SIUE-ARC/cartboard/release-v1/cartboard-F.SilkS.pdf

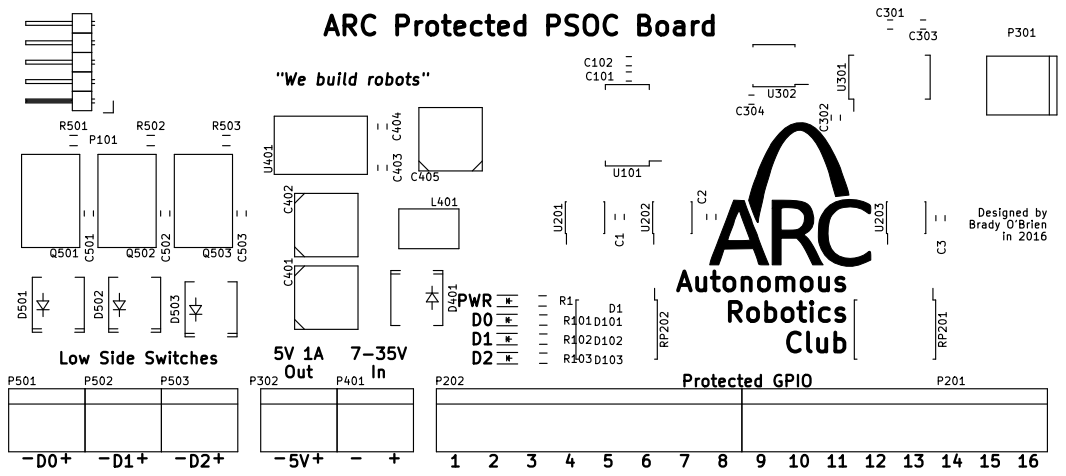
[picture p1: page 1]

in 2016 ARC Protected PSOC Board

Designed by Brady O'Brien
