SIUE-ARC/cartboard/release-v1/cartboard.pdf

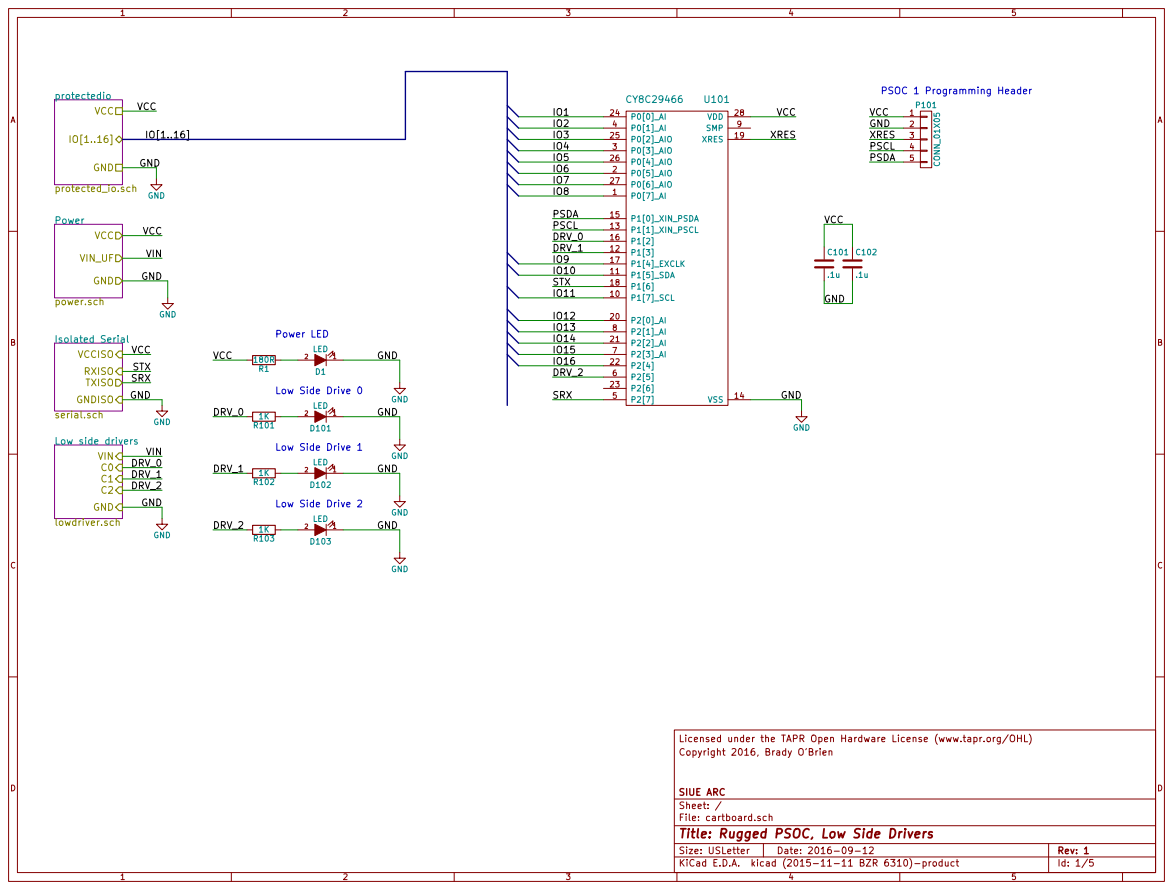
[picture p2: page 1]

Isolated Serial serial.sch VCCISO

Licensed under the TAPR Open Hardware License (www.tapr.org/OHL)
Copyright 2016, Brady O'Brien

File: cartboard.sch Sheet: / SIUE ARC

Id: 1/5 Title: Rugged PSOC, Low Side Drivers

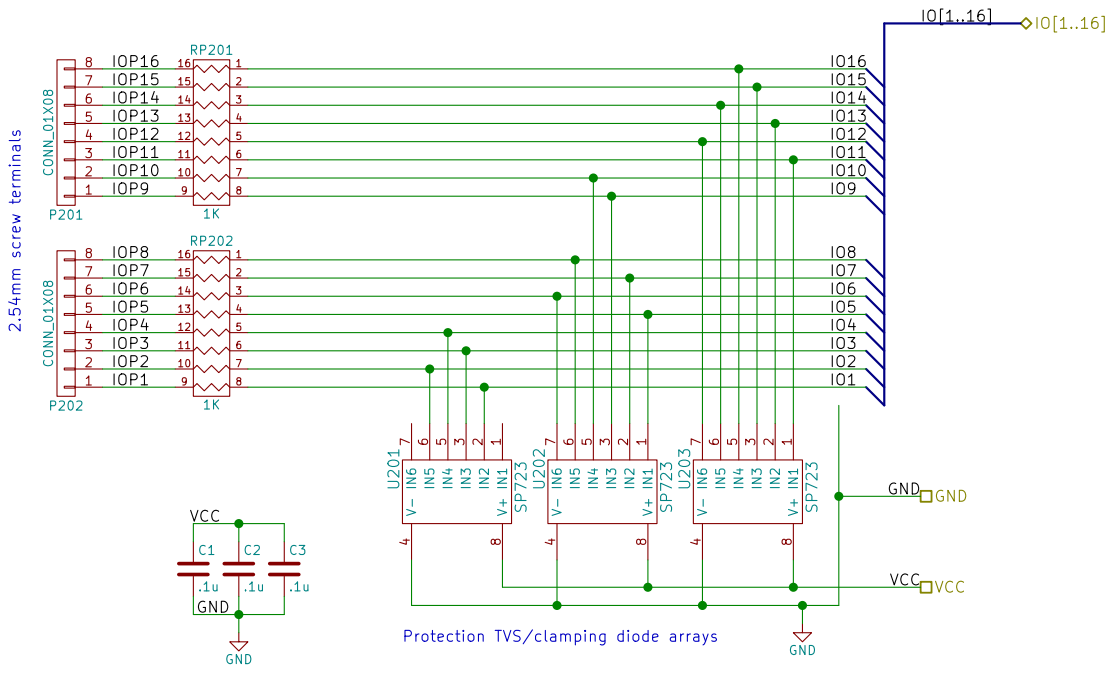
[picture p3: page 2]

2 | IO15
3 | | IO14
4 | | | IO13
5 | | | | IO12
6 | | | | | IO11
7 | | | | | | IO10

2 | IO7
3 | | IO6
4 | | | IO5
5 | | | | IO4
6 | | | | | IO3
7 | | | | | | IO2

Protection TVS/clamping diode arraysIN1

Licensed under the TAPR Open Hardware License (www.tapr.org/OHL)
Copyright 2016, Brady O'Brien

Sheet: /protectedio/ SIUE ARC

File: protected_io.sch
Id: 2/5 Title: Rugged PSOC, Low Side Drivers

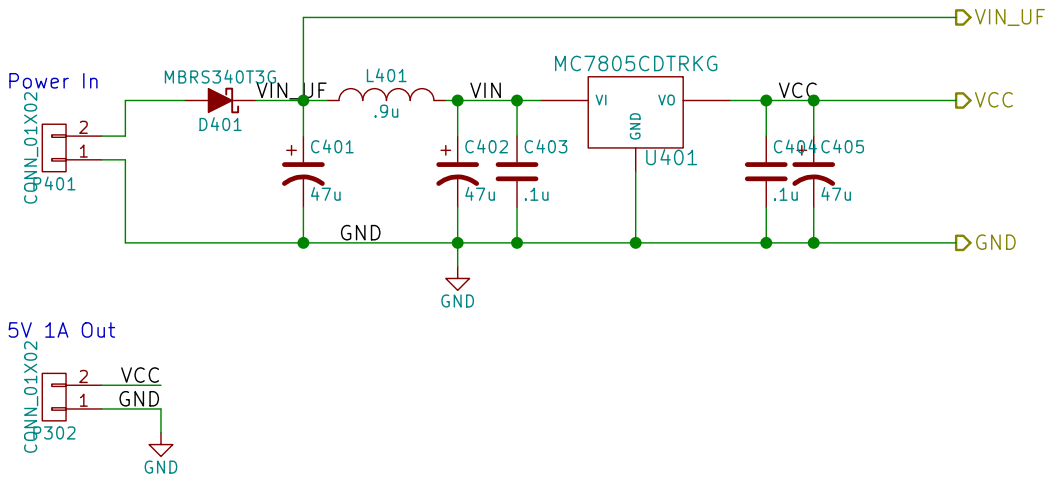
[picture p4: page 3]

Licensed under the TAPR Open Hardware License (www.tapr.org/OHL)
Copyright 2016, Brady O'Brien

File: power.sch Sheet: /Power/ SIUE ARC

Id: 3/5 Title: Rugged PSOC, Low Side Drivers

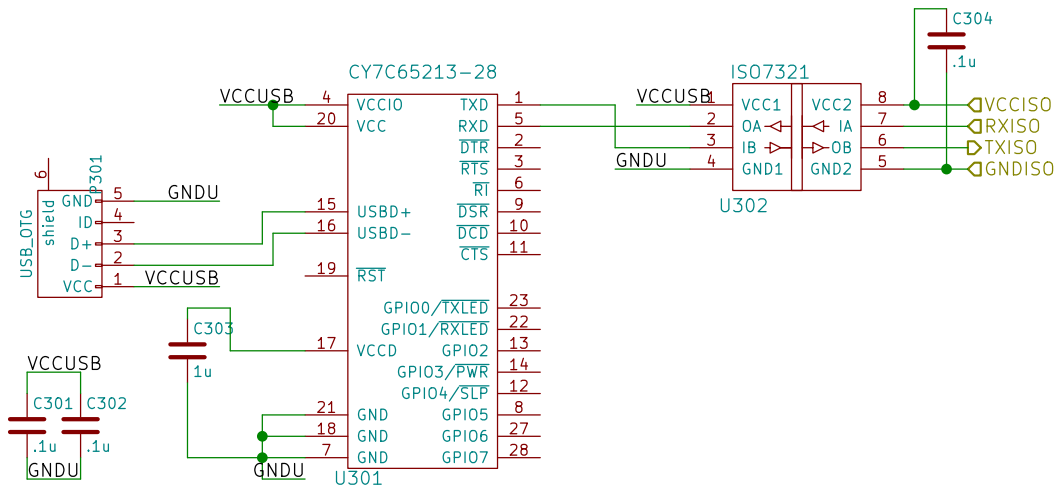
[picture p5: page 4]

Licensed under the TAPR Open Hardware License (www.tapr.org/OHL)
Copyright 2016, Brady O'Brien

File: serial.sch Sheet: /Isolated Serial/ SIUE ARC

Id: 4/5 Title: Rugged PSOC, Low Side Drivers

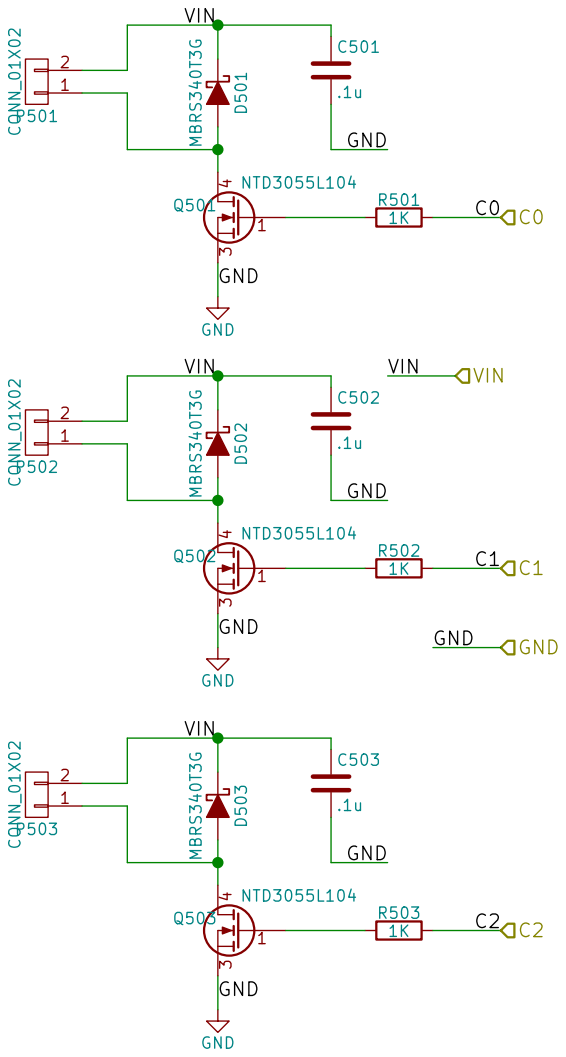
[picture p6: page 5]

Licensed under the TAPR Open Hardware License (www.tapr.org/OHL) D501 MBRS340T3G 1

File: lowdriver.sch Sheet: /Low side drivers/ SIUE ARC

Id: 5/5 Title: Rugged PSOC, Low Side Drivers
