SIUE-ARC/cartboard/release-v1/cartboard-B.Cu.pdf

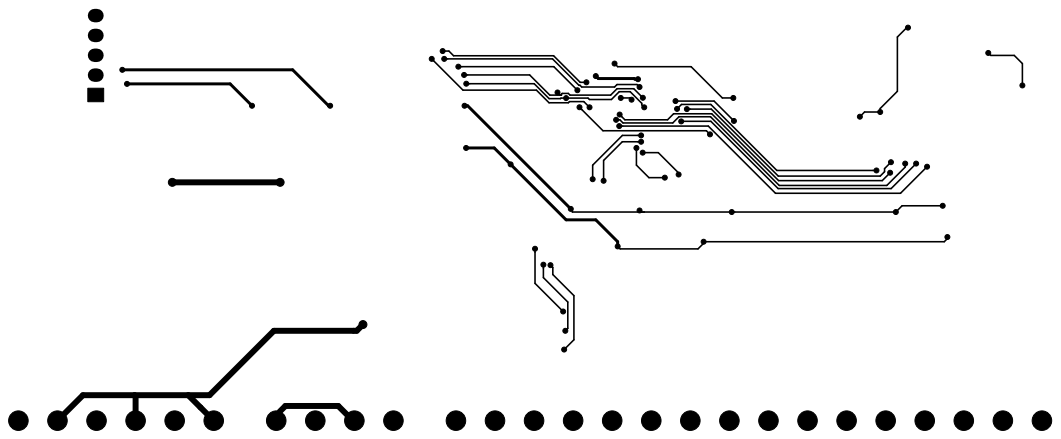
[picture p7: page 1]
