SIUE-ARC/cartboard/release-v1/cartboard-B.Mask.pdf

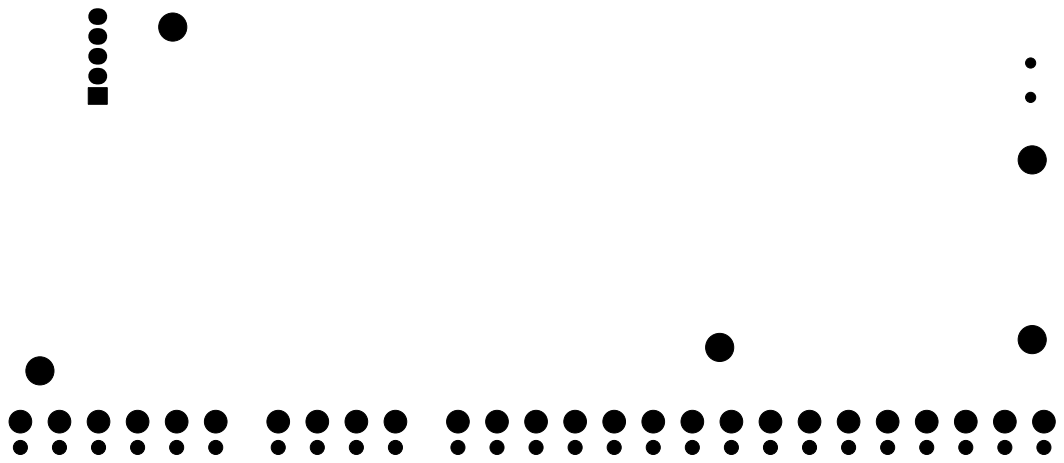
[picture p8: page 1]
