SIUE-ARC/cartboard/release-v1/cartboard-B.SilkS.pdf

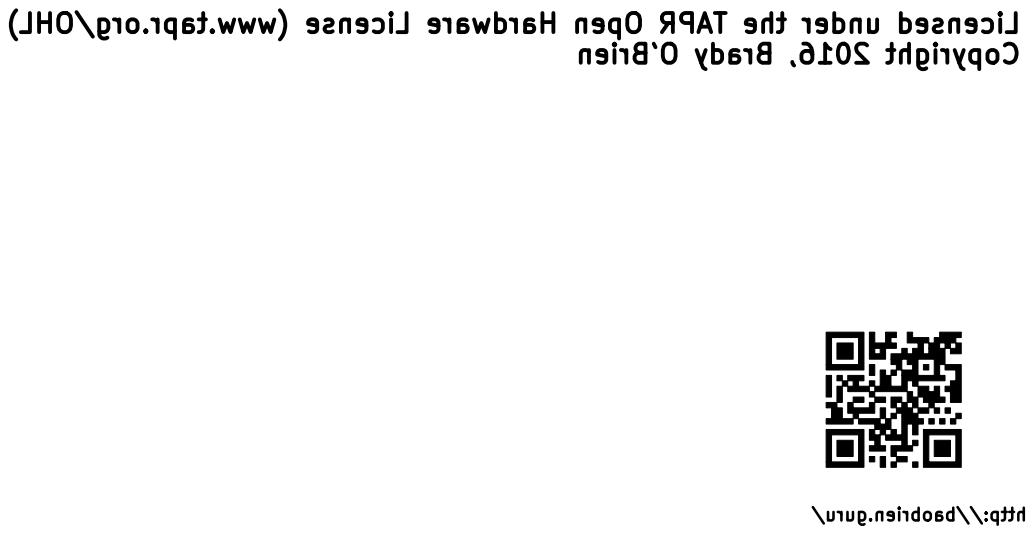
[picture p9: page 1]

Licensed under the TAPR Open Hardware License (www.tapr.org/OHL)
