SIUE-ARC/cartboard/release-v1/cartboard-Cmts.User.pdf

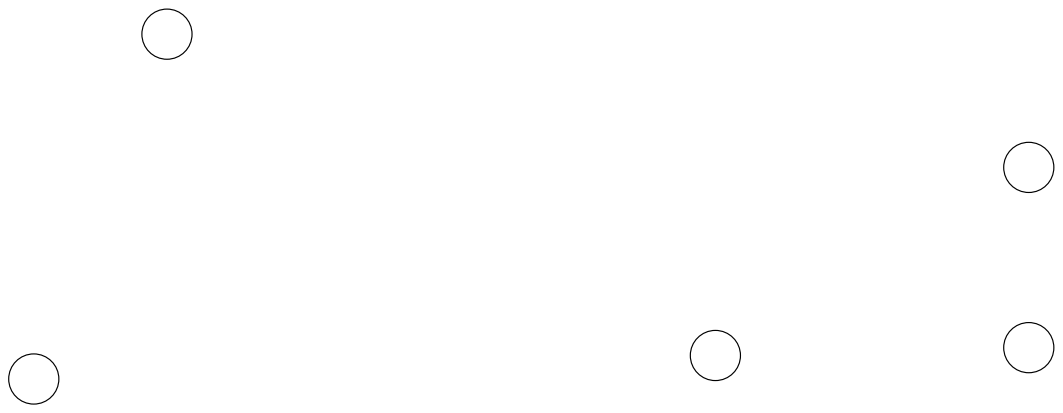
[picture p10: page 1]
