SIUE-ARC/cartboard/release-v1/cartboard-Dwgs.User.pdf

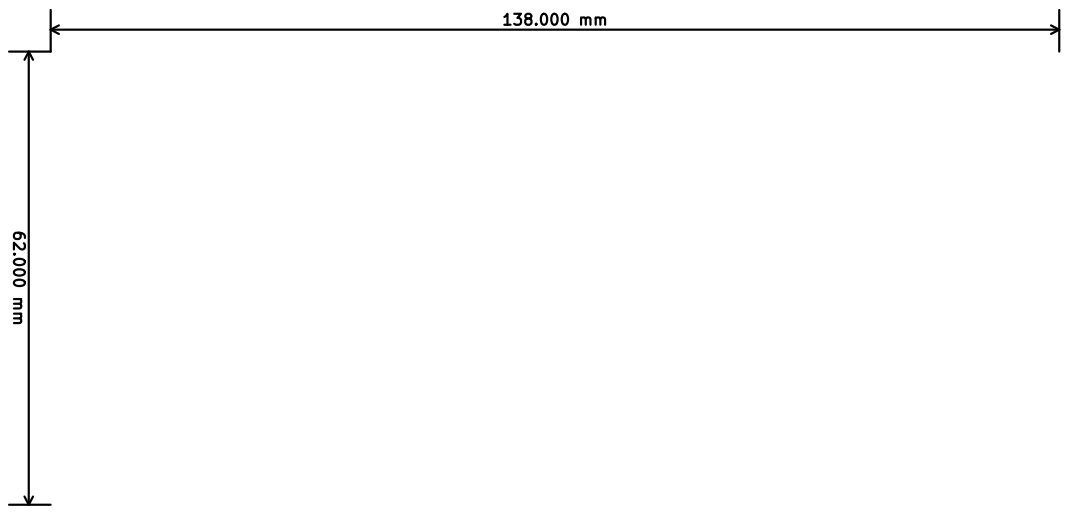
[picture p11: page 1]
