SIUE-ARC/cartboard/release-v1/cartboard-F.Cu.pdf

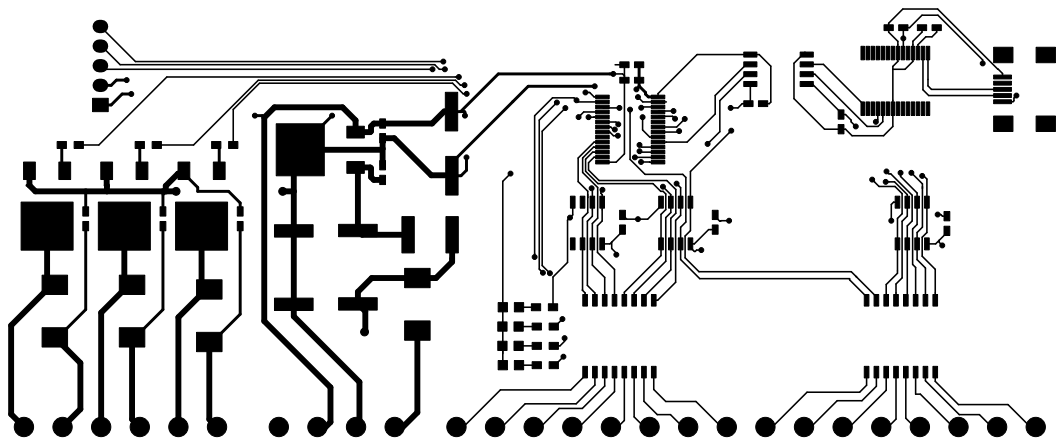
[picture p12: page 1]
