SIUE-ARC/cartboard/release-v1/cartboard-F.Mask.pdf

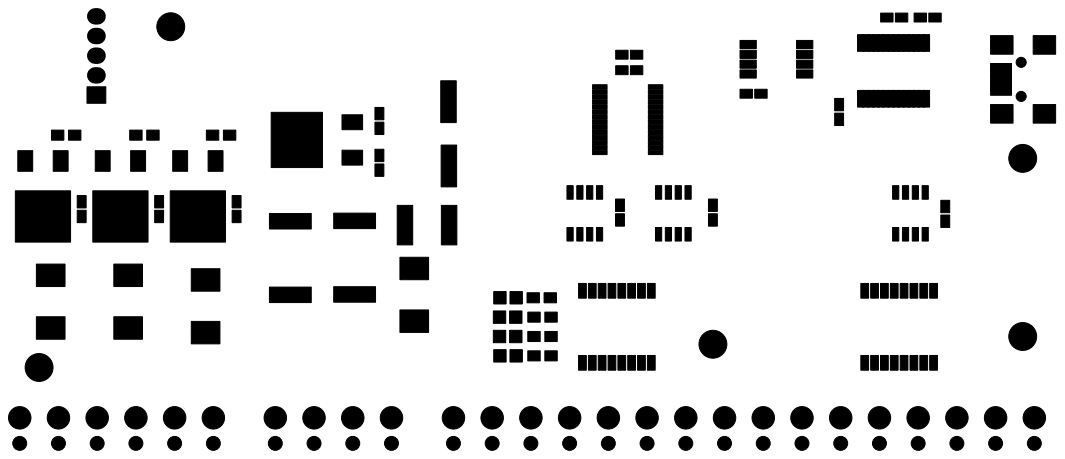
[picture p13: page 1]
