SIUE-ARC/cartboard/release-v1/cartboard-F.Paste.pdf

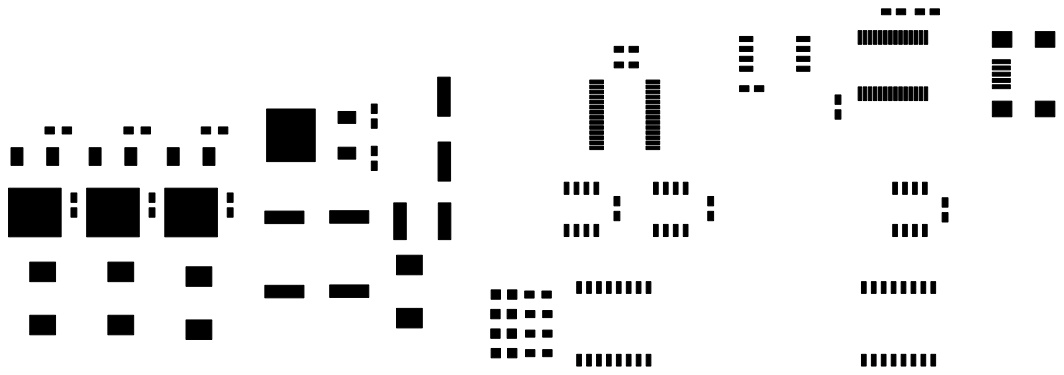
[picture p14: page 1]
