SIUE-ARC/cartboard/cartboard.kicad_pcb

## KiCad design cartboard.kicad_pcb (2016-09-12)

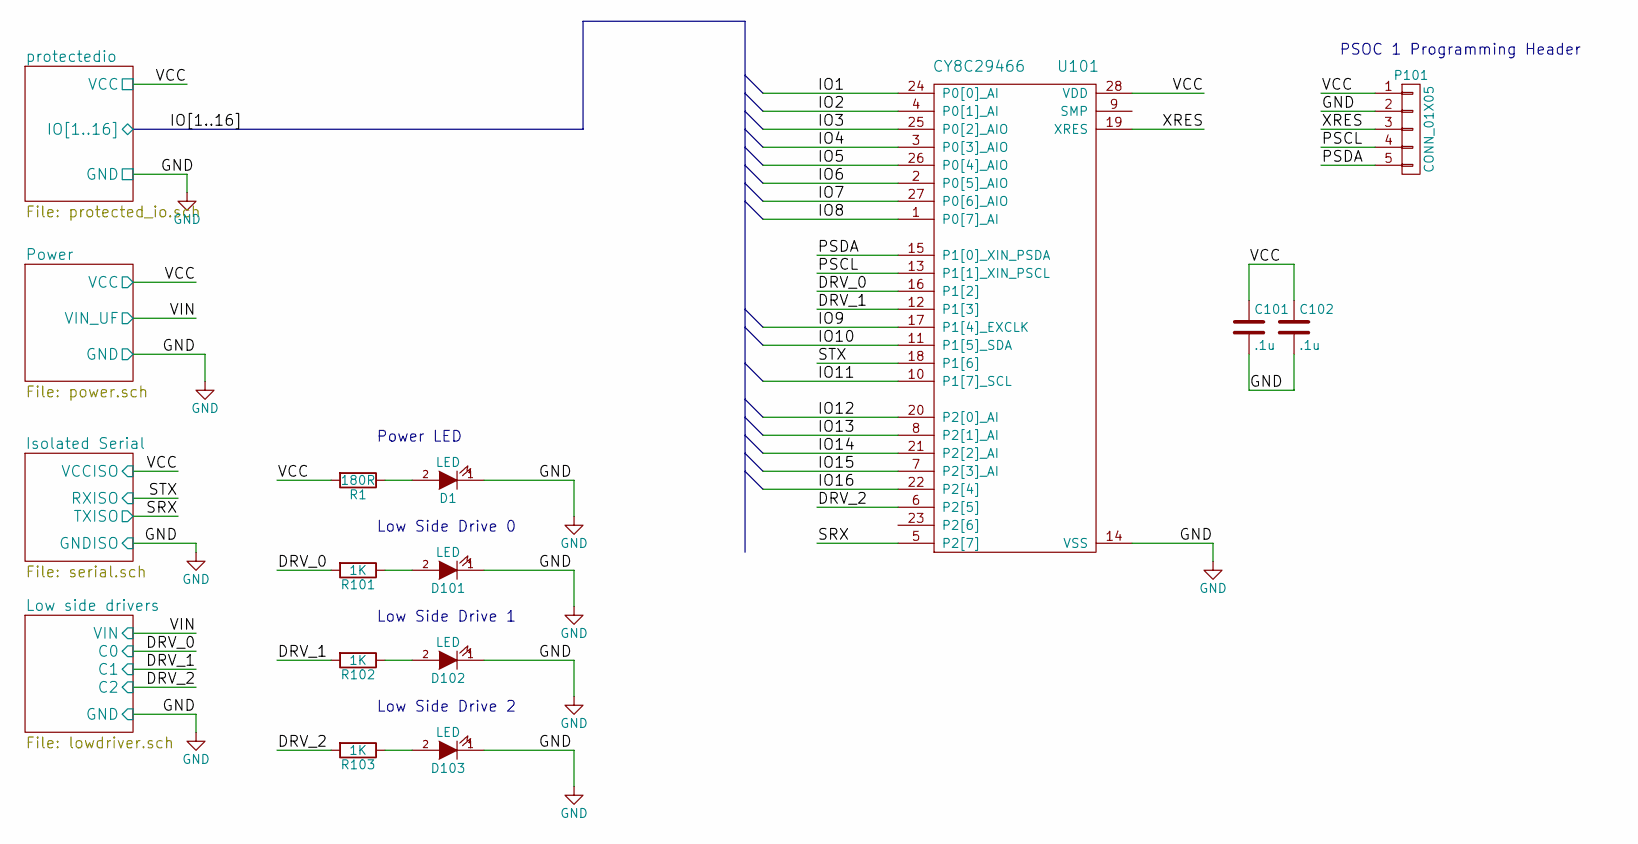
[picture p15: schematic cartboard.sch, Rugged PSOC, Low Side Drivers]

Parts:
C101, C102: .1u; C_0603_HandSoldering
D1, D101, D102, D103: LED; LED_0805; Part APT2012SGC
P101: CONN_01X05; Pin_Header_Angled_1x05; Part WM4203-ND
R1: 180R; R_0603_HandSoldering
R101, R102, R103: 1K; R_0603_HandSoldering
U101: CY8C29466; SSOP-28_5.3x10.2mm_Pitch0.65mm

Connections:
/IO1: U101.24 (P0[0]_AI); also elsewhere on the board
/IO2: U101.4 (P0[1]_AI); also elsewhere on the board
/IO3: U101.25 (P0[2]_AIO); also elsewhere on the board
/IO4: U101.3 (P0[3]_AIO); also elsewhere on the board
/IO5: U101.26 (P0[4]_AIO); also elsewhere on the board
/IO6: U101.2 (P0[5]_AIO); also elsewhere on the board
/IO7: U101.27 (P0[6]_AIO); also elsewhere on the board
/IO8: U101.1 (P0[7]_AI); also elsewhere on the board
/IO9: U101.17 (P1[4]_EXCLK); also elsewhere on the board
/IO10: U101.11 (P1[5]_SDA); also elsewhere on the board
/IO11: U101.10 (P1[7]_SCL); also elsewhere on the board
/IO12: U101.20 (P2[0]_AI); also elsewhere on the board
/IO13: U101.8 (P2[1]_AI); also elsewhere on the board
/IO14: U101.21 (P2[2]_AI); also elsewhere on the board
/IO15: U101.7 (P2[3]_AI); also elsewhere on the board
/IO16: U101.22 (P2[4]); also elsewhere on the board
/Isolated Serial/RXISO: U101.18 (P1[6]); also elsewhere on the board
/Isolated Serial/TXISO: U101.5 (P2[7]); also elsewhere on the board
/Low side drivers/C0: R101.2, U101.16 (P1[2]); also elsewhere on the board
/Low side drivers/C1: R102.2, U101.12 (P1[3]); also elsewhere on the board
/Low side drivers/C2: R103.2, U101.6 (P2[5]); also elsewhere on the board
/PSCL: P101.4, U101.13 (P1[1]_XIN_PSCL)
/PSDA: P101.5, U101.15 (P1[0]_XIN_PSDA)
/Power/VCC: C101.1, C102.1, P101.1, R1.2, U101.28 (VDD); also elsewhere on the board
/XRES: P101.3, U101.19 (XRES)
GND: C101.2, C102.2, D1.1 (K), D101.1 (K), D102.1 (K), D103.1 (K), P101.2, U101.14 (VSS); also elsewhere on the board
unnamed: D1.2 (A), R1.1
unnamed: D101.2 (A), R101.1
unnamed: D102.2 (A), R102.1
unnamed: D103.2 (A), R103.1

Notes on the sheet:
PSOC 1 Programming Header
Power LED
Low Side Drive 0
Low Side Drive 1
Low Side Drive 2

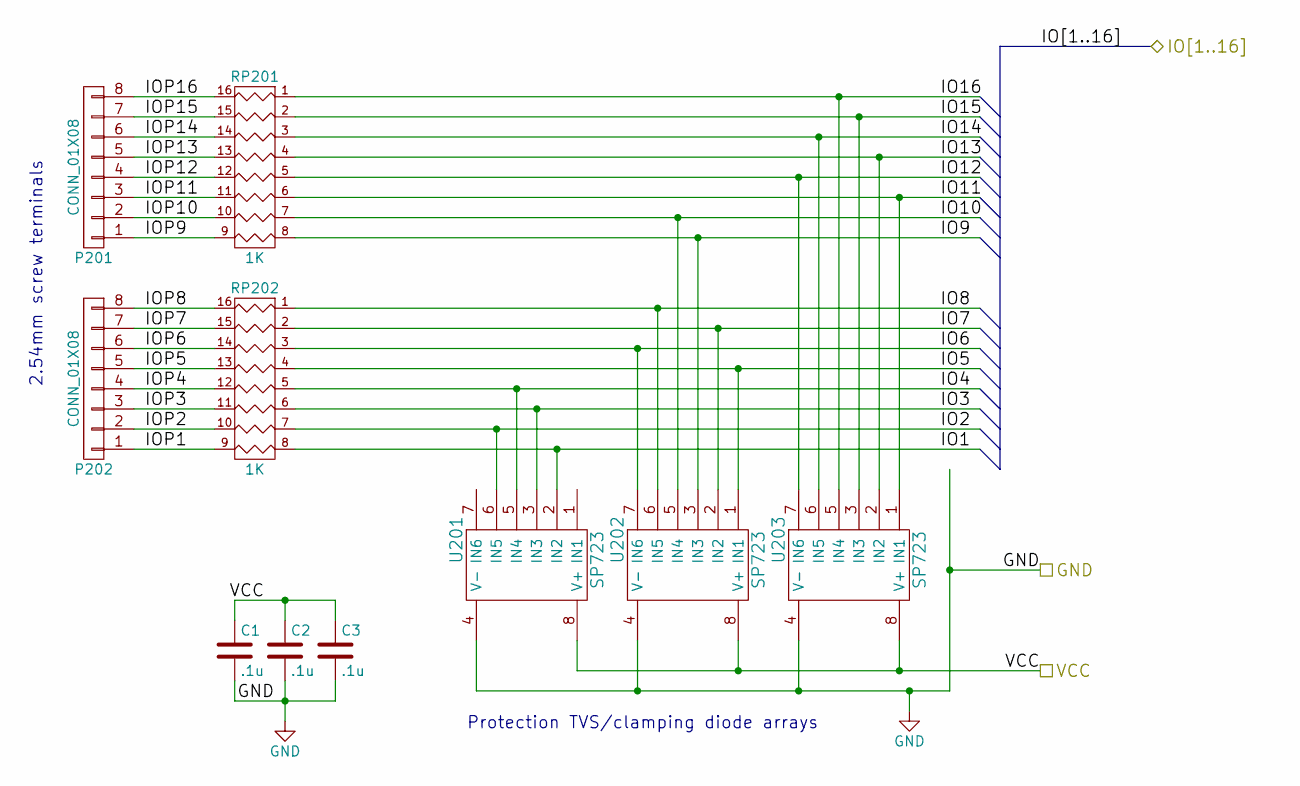
[picture p16: schematic protected_io.sch, Rugged PSOC, Low Side Drivers]

Parts:
C1, C2, C3: .1u; C_0603_HandSoldering
P201, P202: CONN_01X08; TE_TERMBLOCK_5mmx8_282836-8; Part 282836-8
RP201, RP202: 1K; SOIC-16_7.5x10.3mm_Pitch1.27mm; Part 628A102
U201, U202, U203: SP723; SOIC-8_3.9x4.9mm_Pitch1.27mm

Connections:
/IO1: RP202.8, U201.2 (IN2); also elsewhere on the board
/IO2: RP202.7, U201.6 (IN5); also elsewhere on the board
/IO3: RP202.6, U201.3 (IN3); also elsewhere on the board
/IO4: RP202.5, U201.5 (IN4); also elsewhere on the board
/IO5: RP202.4, U202.1 (IN1); also elsewhere on the board
/IO6: RP202.3, U202.7 (IN6); also elsewhere on the board
/IO7: RP202.2, U202.2 (IN2); also elsewhere on the board
/IO8: RP202.1, U202.6 (IN5); also elsewhere on the board
/IO9: RP201.8, U202.3 (IN3); also elsewhere on the board
/IO10: RP201.7, U202.5 (IN4); also elsewhere on the board
/IO11: RP201.6, U203.1 (IN1); also elsewhere on the board
/IO12: RP201.5, U203.7 (IN6); also elsewhere on the board
/IO13: RP201.4, U203.2 (IN2); also elsewhere on the board
/IO14: RP201.3, U203.6 (IN5); also elsewhere on the board
/IO15: RP201.2, U203.3 (IN3); also elsewhere on the board
/IO16: RP201.1, U203.5 (IN4); also elsewhere on the board
/Power/VCC: C1.1, C2.1, C3.1, U201.8 (V+), U202.8 (V+), U203.8 (V+); also elsewhere on the board
/protectedio/IOP1: P202.1, RP202.9 (R8)
/protectedio/IOP2: P202.2, RP202.10 (R7)
/protectedio/IOP3: P202.3, RP202.11 (R6)
/protectedio/IOP4: P202.4, RP202.12 (R5)
/protectedio/IOP5: P202.5, RP202.13 (R4)
/protectedio/IOP6: P202.6, RP202.14 (R3)
/protectedio/IOP7: P202.7, RP202.15 (R2)
/protectedio/IOP8: P202.8, RP202.16 (R1)
/protectedio/IOP9: P201.1, RP201.9 (R8)
/protectedio/IOP10: P201.2, RP201.10 (R7)
/protectedio/IOP11: P201.3, RP201.11 (R6)
/protectedio/IOP12: P201.4, RP201.12 (R5)
/protectedio/IOP13: P201.5, RP201.13 (R4)
/protectedio/IOP14: P201.6, RP201.14 (R3)
/protectedio/IOP15: P201.7, RP201.15 (R2)
/protectedio/IOP16: P201.8, RP201.16 (R1)
GND: C1.2, C2.2, C3.2, U201.4 (V-), U202.4 (V-), U203.4 (V-); also elsewhere on the board

Notes on the sheet:
Protection TVS/clamping diode arrays
2.54mm screw terminals

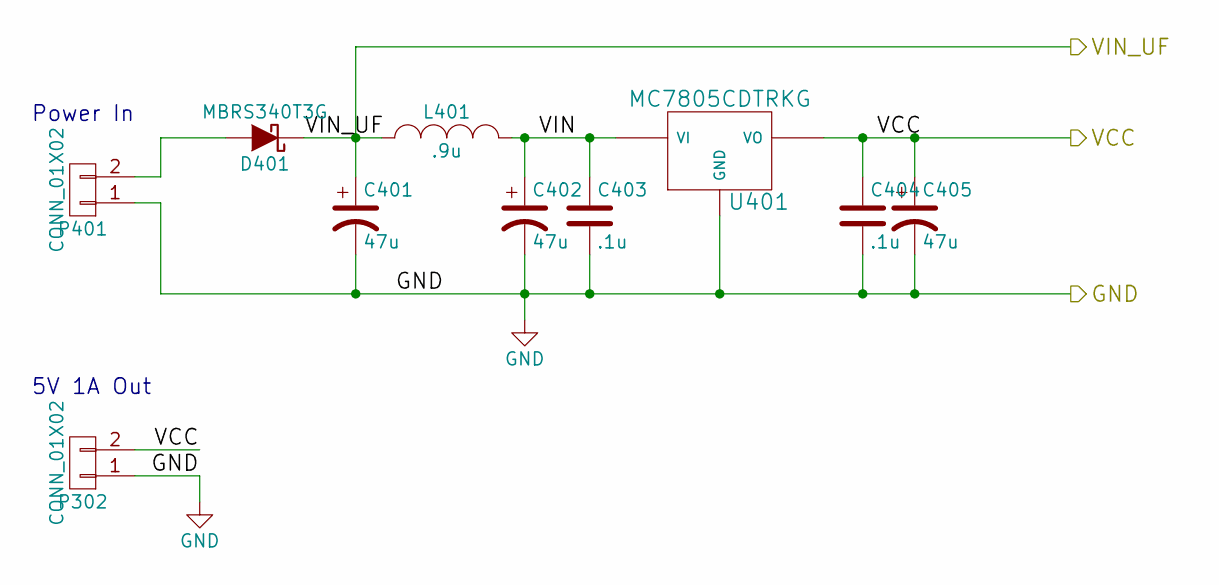
[picture p17: schematic power.sch, Rugged PSOC, Low Side Drivers]

Parts:
C401, C402, C405: 47u; CAP_UCD1H470MCL6GS; part UCD1H470MCL6GS
C403, C404: .1u; C_0603_HandSoldering
D401: MBRS340T3G; SMC_Standard; Part MBRS340T3G
L401: .9u; L_NRS; Part NRS6028T0R9NMGJV
P302, P401: CONN_01X02; TE_TERMBLOCK_5mmx2_282836-2; Part ED2609-ND
U401: MC7805CDTRKG; D-PAK3

Connections:
/Low side drivers/VIN: C401.1, D401.1 (K), L401.1; also elsewhere on the board
/Power/VCC: C404.1, C405.1, P302.2, U401.3 (VO); also elsewhere on the board
/Power/VIN: C402.1, C403.1, L401.2, U401.1 (VI)
GND: C401.2, C402.2, C403.2, C404.2, C405.2, P302.1, P401.1, U401.4 (GND); also elsewhere on the board
unnamed: D401.2 (A), P401.2

Notes on the sheet:
Power In
5V 1A Out

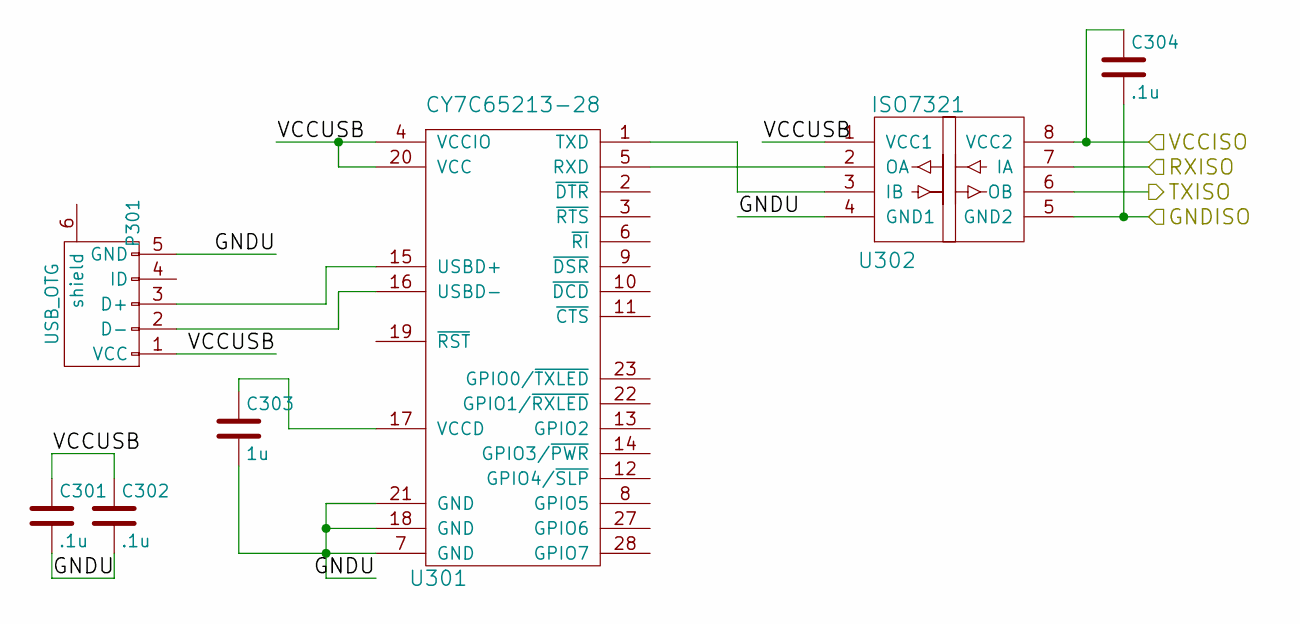
[picture p18: schematic serial.sch, Rugged PSOC, Low Side Drivers]

Parts:
C301, C302, C304: .1u; C_0603_HandSoldering
C303: 1u; C_0603_HandSoldering
P301: USB_OTG; USB_Mini-B; Part 65100516121
U301: CY7C65213-28; SSOP-28_5.3x10.2mm_Pitch0.65mm; Part CY7C65213-28PVXI
U302: ISO7321; SOIJ-8_5.3x5.3mm_Pitch1.27mm

Connections:
/Isolated Serial/GNDU: C301.2, C302.2, C303.2, P301.5 (GND), U301.7 (GND), U301.18 (GND), U301.21 (GND), U302.4 (GND1)
/Isolated Serial/RXISO: U302.7 (IA); also elsewhere on the board
/Isolated Serial/TXISO: U302.6 (OB); also elsewhere on the board
/Isolated Serial/VCCUSB: C301.1, C302.1, P301.1 (VCC), U301.4 (VCCIO), U301.20 (VCC), U302.1 (VCC1)
/Power/VCC: C304.1, U302.8 (VCC2); also elsewhere on the board
GND: C304.2, U302.5 (GND2); also elsewhere on the board
unnamed: C303.1, U301.17 (VCCD)
unnamed: P301.2 (D-), U301.16 (USBD-)
unnamed: P301.3 (D+), U301.15 (USBD+)
unnamed: U301.1 (TXD), U302.3 (IB)
unnamed: U301.5 (RXD), U302.2 (OA)

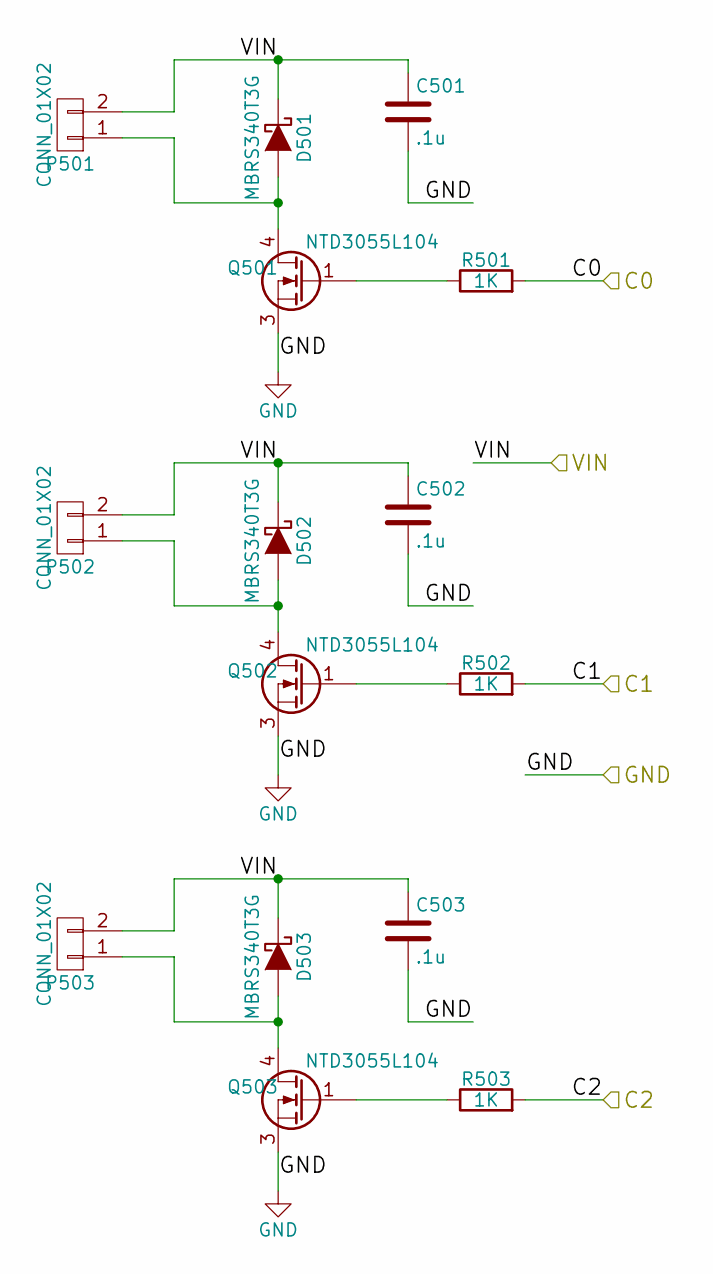
[picture p19: schematic lowdriver.sch, Rugged PSOC, Low Side Drivers]

Parts:
C501, C502, C503: .1u; C_0603_HandSoldering
D501, D502, D503: MBRS340T3G; SMC_Standard
P501, P502, P503: CONN_01X02; TE_TERMBLOCK_5mmx2_282836-2
Q501, Q502, Q503: NTD3055L104; D-PAK3
R501, R502, R503: 1K; R_0603_HandSoldering

Connections:
/Low side drivers/C0: R501.2; also elsewhere on the board
/Low side drivers/C1: R502.2; also elsewhere on the board
/Low side drivers/C2: R503.2; also elsewhere on the board
/Low side drivers/VIN: C501.1, C502.1, C503.1, D501.1 (K), D502.1 (K), D503.1 (K), P501.2, P502.2, P503.2; also elsewhere on the board
GND: C501.2, C502.2, C503.2, Q501.3 (S), Q502.3 (S), Q503.3 (S); also elsewhere on the board
unnamed: D501.2 (A), P501.1, Q501.4 (D)
unnamed: D502.2 (A), P502.1, Q502.4 (D)
unnamed: D503.2 (A), P503.1, Q503.4 (D)
unnamed: Q501.1 (G), R501.1
unnamed: Q502.1 (G), R502.1
unnamed: Q503.1 (G), R503.1

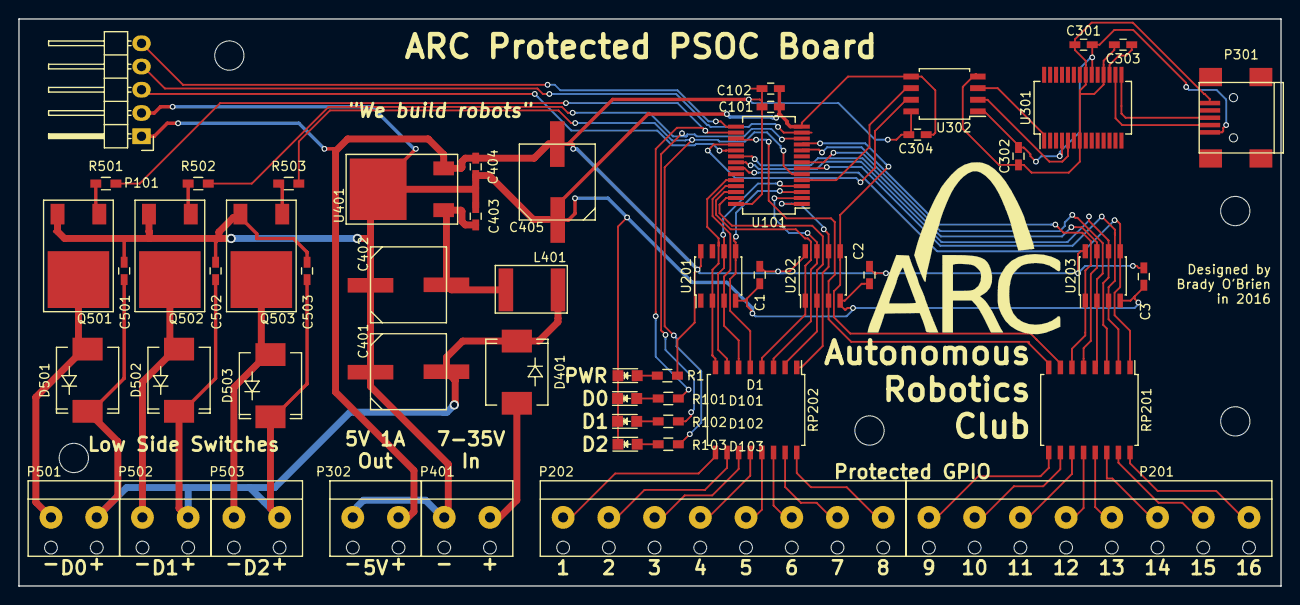
[picture p20: board cartboard.kicad_pcb from above]

Board: 2 copper layers, 138.0 x 62.0 mm, 59 parts (0 on the bottom side), 62 nets.

Other parts of the board:
MH1, MH1#2, MH1#3, MH1#4, MH1#5: MountingHole_3.2mm_M3
