SIUE-ARC/cartboard/(commit log)

2016-09-12 First 'release'
    [cartboard-B.Cu.gbl, cartboard-B.Mask.gbs, cartboard-B.SilkS.gbo, cartboard-Cmts.User.gbr, cartboard-Dwgs.User.gbr, cartboard-Edge.Cuts.gm1, cartboard-F.Cu.gtl, cartboard-F.Mask.gts]
2016-09-12 moved BOM into release directory
    [Cartboard_BOM.ods]
2016-09-12 Fixed BOM
    [Cartboard_BOM.ods, bomraw.csv, cartboard.kicad_pcb, output.csv]
2016-09-12 Fixed BOM and made pretty PDF BOM
    [Cartboard_BOM.ods, Cartboard_BOM.xls]
2016-09-12 Changed the silkscreen layers and set a new release
    [cartboard-B.Cu.gbl, cartboard-B.Mask.gbs, cartboard-B.Paste.gbp, cartboard-B.SilkS.gbo, cartboard-Cmts.User.gbr, cartboard-Dwgs.User.gbr, cartboard-Edge.Cuts.gko, cartboard-F.Cu.gtl]
2016-09-12 silkscreen change
    [cartboard.kicad_pcb]
2016-09-12 Added TAPR OHL as license
    [cartboard-B.Cu.gbl, cartboard-B.Mask.gbs, cartboard-B.SilkS.gbo, cartboard-Cmts.User.gbr, cartboard-Dwgs.User.gbr, cartboard-Edge.Cuts.gm1, cartboard-F.Cu.gtl, cartboard-F.Mask.gts]
